ara-aras/esp32-mini-drone/PPT/Drone_Workshop_v2.pptx

M1

M2

M4

M3

IEEE WEEK 2026 · MECH. ENGG.

Introduction
to Drone
Technology

Turn code into motion.
13 Oct · MPH · 9:30–12:30

ESP32 · 500 Hz

AO3400 drivers

6S brushless FPV

ESP32

MPU-6050

Notes: Welcome. Today is about how a drone flies and how we're building one. Our first prototype spun its props and skated across the floor, but it never lifted off. We worked out why, and the second prototype, with a different motor driver, is being built now. We'll start with the physics, then our two prototypes, the firmware, and finally how a full 6S racing drone differs.

## Slide 2

Five stops from physics to flight

02 / ROADMAP

Flight physics

How 4 motors steer
roll, pitch, yaw
and thrust

SLIDES 3–9

01

02

Micro build

Parts, the driver
that failed, and
the MOSFET fix

SLIDES 10–14

500 Hz loop, PID,
motor mixer and
radio links

SLIDES 15–17

03

Firmware

Pro FPV stack

Brushless motors,
DShot and 6S power

SLIDES 18–22

04

Bench rules, flight
modes, PID tuning

SLIDES 23–25

05

Fly safely

Build, Fly & Tune a Drone from Scratch

02 / 26

Notes: Here is the route for today, five stops climbing from theory to flight. First the physics of how four motors steer a quad. Then our micro build on an ESP32, including the driver that failed and the MOSFET fix. Then the firmware: the 500 hertz loop, the PID controller, the motor mixer and the radio links. Then we scale up to a five-inch FPV racer with brushless motors, DShot and 6S power. And finally how to fly safely: bench rules, flight modes and PID tuning.

## Slide 3

How four motors steer a quad

03 / FLIGHT PHYSICS

CW

CCW

CCW

CW

M1 · FL

M2 · FR

M4 · RL

M3 · RR

M1 + M4 (left side)
spin faster

Roll

lean right

M2 + M4 (CCW pair)
spin faster

Yaw

turn right

M3 + M4 (rear pair)
spin faster

Pitch

nose down

All four together;
aim for ≈ 2:1 thrust

Throttle

climb

FRONT ↑

Filled motor = spins faster · Body frame: X forward, Y right, Z down

03 / 26

Notes: A quadcopter steers only by changing how fast each motor spins. Watch the props: M1 front left spins clockwise, M2 front right counter-clockwise, M3 rear right clockwise, M4 rear left counter-clockwise. Neighbours spin opposite ways so their torques cancel and the frame doesn't spin on its own. To roll right, the left pair speeds up. To pitch nose down and fly forward, the rear pair speeds up. To yaw right, the counter-clockwise pair, M2 and M4, speeds up and its reaction torque turns the frame. Throttle is all four together. Hovering needs thrust equal to weight; aim for about 2:1 so there's room left for control. The next slides show roll and pitch in both directions.

## Slide 4

Which prop goes on which motor

03 / FLIGHT PHYSICS

CW

CCW

CCW

CW

M1 · FL

M2 · FR

M4 · RL

M3 · RR

CW prop

on M1 (front left) + M3 (rear right)

CCW prop

on M2 (front right) + M4 (rear left)

blade moves

blade moves

FRONT ↑

air down

air down

Cross-section of one blade · dot = leading edge

The raised, thicker edge of each blade leads, so it bites into the air in the direction the motor turns.

Check: spin each prop by hand the way its motor turns. You should feel air pushed down. A prop on the wrong motor pushes air up, and the drone flips over on take-off.

Props come in matched pairs. Check the arrow or letter on the pack, not just the shape.

04 / 26

Notes: Before anything flies, the props have to match the motors. Clockwise motors, M1 front left and M3 rear right, take clockwise props. Counter-clockwise motors, M2 and M4, take counter-clockwise props. You can tell them apart by the blade: the raised, thicker edge goes first in the direction of rotation, like a wing leading into the air. Props come in matched pairs, so check the arrow or letter printed on them too. Quick test: spin each prop by hand the way its motor turns and feel for air going down. Put one on backwards and that corner pushes air up, and the drone flips the moment it tries to take off.

## Slide 5

03 / FLIGHT PHYSICS

Roll: one side speeds up

CW

CCW

CCW

CW

M1 · FL

M2 · FR

M4 · RL

M3 · RR

FRONT ↑

Roll right

M1 + M4 spin faster

The left side lifts, so the drone leans right and slides that way.

Front view, seen from behind

Filled motor = spins faster · Body frame: X forward, Y right, Z down

05 / 26

Notes: Roll right. M1 and M4, the two motors on the left, spin faster. The left side lifts, the drone leans right, and part of its thrust now pushes it sideways, so it slides right.

## Slide 6

03 / FLIGHT PHYSICS

Roll: one side speeds up

CW

CCW

CCW

CW

M1 · FL

M2 · FR

M4 · RL

M3 · RR

FRONT ↑

Roll left

M2 + M3 spin faster

The right side lifts, so the drone leans left and slides that way.

Front view, seen from behind

Filled motor = spins faster · Body frame: X forward, Y right, Z down

06 / 26

Notes: Now the opposite. M2 and M3 on the right side speed up, the right side lifts, and the drone leans and slides left.

## Slide 7

Pitch: front or back speeds up

03 / FLIGHT PHYSICS

CW

CCW

CCW

CW

M1 · FL

M2 · FR

M4 · RL

M3 · RR

FRONT ↑

Pitch forward

M3 + M4 spin faster

The tail lifts, the nose dips, and the drone moves forward.

Side view, nose on the right

Filled motor = spins faster · Body frame: X forward, Y right, Z down

07 / 26

Notes: Pitch forward. The rear pair, M3 and M4, speeds up. The tail rises, the nose dips, and the tilted thrust pulls the drone forward.

## Slide 8

Pitch: front or back speeds up

03 / FLIGHT PHYSICS

CW

CCW

CCW

CW

M1 · FL

M2 · FR

M4 · RL

M3 · RR

FRONT ↑

Pitch back

M1 + M2 spin faster

The nose lifts and the drone moves backward.

Side view, nose on the right

Filled motor = spins faster · Body frame: X forward, Y right, Z down

08 / 26

Notes: Pitch back is the mirror image. The front pair, M1 and M2, speeds up, the nose comes up, and the drone moves backward.

## Slide 9

04 / TWO MACHINES

Our two drones

Prototype 1

DRV8833

ESP32, customised ESP-Drone FW

8520 coreless brushed

2 × DRV8833 H-bridge boards

ESP-NOW remote + phone app

Skated, never lifted off

Built and tested

motor driver

BRAIN

MOTORS

DRIVER

RADIO

RESULT

ESP32, customised ESP-Drone FW

8520 coreless brushed

4 × AO3400 MOSFETs

ESP-NOW remote + phone app

Not built yet

Prototype 2

AO3400

Being built

motor driver

BRAIN

MOTORS

DRIVER

RADIO

STATUS

Build, Fly & Tune a Drone from Scratch

09 / 26

Notes: These are our two drones. Both use an ESP32, an MPU-6050, four 8520 coreless motors and a single LiPo cell, and both run firmware we customised from Espressif's official ESP-Drone firmware. The only difference is the motor driver. Prototype 1 used two DRV8833 H-bridge boards. It spun its props but never lifted off. Prototype 2 replaces them with four AO3400 MOSFETs, one per motor, and we're still building it.

## Slide 10

What is on our 50-gram quad

05 / MICRO BUILD

ESP32 DevKit V1

Dual-core 240 MHz; one core
runs the 500 Hz flight loop

MPU-6050 IMU

3-axis gyro + accelerometer,
I²C at 400 kHz, at the CG

8520 coreless motor × 4

8.5 × 20 mm, about 5 g each,
turning 55 mm props

ESP32

1S LiPo power

3.7 V cell, TP4056 USB charger,
5 V boost keeps the ESP32 stable,
voltage read on GPIO 34
(100k / 100k divider)

AO3400 driver × 4

One low-side MOSFET per motor,
16 kHz PWM from the ESP32

Dashed teal outline = battery under the frame · Orange squares = MOSFET drivers

10 / 26

Notes: Here's what goes on the quad. The ESP32 DevKit is the brain: dual core at 240 MHz, and one core runs the 500 Hz flight loop. The MPU-6050 gives us a three-axis gyro and accelerometer over I2C at 400 kHz, and it sits at the centre of gravity so rotation doesn't show up as false acceleration. The 8520 coreless motors are 8.5 by 20 mm, about 5 g each, on 55 mm props. In prototype 2 each motor gets its own AO3400 MOSFET, switched at 16 kHz. Power is one LiPo cell with a TP4056 USB charger, a 5 V boost so the ESP32 doesn't brown out, and a 100k/100k divider so we can read the battery voltage on GPIO 34.

## Slide 11

< 2.7 V

reached the motors (measured)

from a battery rated 3.7 V

props spinning, no lift

06 / THE ROADBLOCK

Prototype 1 never
left the floor

ESP32, MPU-6050, four 8520 motors,
a 1S LiPo, and two DRV8833
H-bridge boards driving the motors.

At full throttle the props spun,
but the quad only skated across
the floor. It never lifted off.

Phase 2 · Micro build

11 / 26

Notes: Prototype 1 had the same ESP32, IMU, motors and battery, with two DRV8833 H-bridge boards driving the motors. At full throttle the props spun, but the quad only skated across the floor. It never lifted off. At the motor terminals we read under 2.7 V from a 3.7 V battery, so about a volt was going missing somewhere.

## Slide 12

Where the missing volt went

07 / DIAGNOSIS

3.7 V nominal

1S LiPo

3.7 V

I ≈ 3.5 A

DRV8833

≈ 360 mΩ

< 2.7 V

8520 motor

M

In the chip:

3.5 A × 0.36 Ω ≈ 1.3 V

never reaches the motor

Driver limit

1.5 A RMS, 2 A peak
per channel (datasheet)

Motor demand

8520s pull 3.5–4.2 A
at full throttle

Not enough lift

Less voltage at the motor,
so the props can't lift it

Lesson: H-bridge ICs suit 0.5–0.8 A toy-car motors. Coreless drone motors need a bigger switch.

DRV8833 figures: TI datasheet (typical RDS(on) high + low side). Motor current: typical 8520 stall figure.

12 / 26

Notes: Follow the current. Inside each DRV8833 channel it passes through a high-side and a low-side transistor, about 360 milliohms in total according to TI's datasheet. At full throttle an 8520 motor wants 3.5 to 4 A. Ohm's law: 3.5 A times 0.36 ohm is about 1.3 V dropped inside the chip, so it never reaches the motor. The chip is also rated for only 1.5 A RMS per channel. With less voltage the motors can't spin fast enough to lift the quad. H-bridge chips like this are made for toy-car motors that run in both directions at under an amp. A drone motor turns one way and needs a lot more current.

## Slide 13

One MOSFET per motor

08 / THE FIX

VBAT 3.7 V

SS24

8520

PWM

AO3400

10 kΩ

GND

3

1

2

M

ESP32 GPIO

Current path: battery → motor → switch → ground

M1 GPIO32 · M2 GPIO25 · M3 GPIO33 · M4 GPIO26

16 kHz, 12-bit PWM from the ESP32 LEDC timers

Low-side switch, ×4. Pins from Drone/src/config.h

13 / 26

AO3400 N-channel MOSFET

Logic-level: a 3.3 V gate turns it fully
on. Tens of mΩ, 5.7 A continuous.

1

Battery +
3.7 V

M

8520 motor

3

AO3400
switch

1

GND

SS24 diode across the motor: catches the spike when the switch opens

PWM: on/off 16,000 times a second. More on-time = faster motor.

10 kΩ gate pull-down

Holds the gate low while the ESP32 boots,
so motors cannot twitch at power-up.

2

2

10 kΩ gate to GND keeps the switch off while the ESP32 boots

ESP32 GPIO

SS24 Schottky diode (40 V, 2 A)

Gives the motor current a path when the
switch opens, so there is no voltage spike.

3

Notes: Prototype 2 swaps the H-bridge for one N-channel MOSFET per motor. Read the diagram left to right: current leaves the battery, goes through the motor, then through the MOSFET, and into ground. The MOSFET is just a switch. The ESP32 turns it on and off 16,000 times a second, and the share of time it's on sets the motor speed. Three parts make it work. The AO3400 is logic-level, so the ESP32's 3.3 V turns it fully on, with tens of milliohms of resistance and a 5.7 A rating. A 10 k resistor from gate to ground keeps it off while the ESP32 boots, so the motors can't twitch at power-up. And the SS24 diode across the motor gives the motor's current somewhere to go when the switch opens, so there's no voltage spike. Motors 1 to 4 use GPIO 32, 25, 33 and 26.

## Slide 14

09 / BEFORE VS AFTER

Same motors, new driver

1.5 A RMS · 2 A peak

< 2.7 V (measured)

Built and tested

Skated on the floor

≈ 360 mΩ

DRV8833 H-bridge

✕ FAILED

Tens of mΩ (≈ 10× less)

5.7 A continuous

≈ 3.5 V (calculated)

Not built yet

Should lift off

AO3400 MOSFET

PLANNED

RESISTANCE

CURRENT

AT MOTOR

STATUS

RESULT

Same motors, same battery, same code. Only the driver changes.

First test once it's built: measure the voltage at the motor terminals.

Build, Fly & Tune a Drone from Scratch

14 / 26

Notes: Here's what should change. The DRV8833 path is about 360 milliohms; the MOSFET is tens of milliohms, roughly ten times less. The DRV8833 is rated 1.5 A RMS; the AO3400 handles 5.7 A continuous. At 3.5 A through about 50 milliohms we'd lose around 0.2 V, so we expect roughly 3.5 V at the motor. That's a calculation, not a measurement, because prototype 2 isn't built yet. Same motors, same battery, same code: only the driver changes. Once it's built, the first thing we'll do is put a multimeter on the motor terminals.

## Slide 15

Two cores, one 500 Hz flight loop

10 / FIRMWARE

CORE 0 · WI-FI + ESP-NOW STACK

Radio receives stick packets from the remote or the phone app

Read IMU

Fuse

PID

Mix

PWM out

gyro + accel, I²C

attitude estimate

angle → rate loop

Quad-X mixer

4 motors, 16 kHz

CORE 1 · FLIGHT TASK · 500 Hz

setpoints

Commands

Telemetry

Battery + LED

Motor watchdog

serial + web page

+ blackbox log

voltage, status

task silent 50 ms → cut

CORE 1 · loop() · LOW PRIORITY

Rule: only the flight task touches I²C and the motors; the rest uses locked shared data.

Arduino framework on FreeRTOS · no external libraries

15 / 26

Notes: Now the firmware. The ESP32 has two cores. Core zero runs the Wi-Fi and ESP-NOW radio stack, which receives stick packets and turns them into setpoints. Core one runs our flight task every two milliseconds, five hundred times a second, at high priority: read the IMU, fuse the readings into an attitude estimate, run the PID controller, mix the corrections into four motor outputs, and write the PWM. Also on core one, at low priority, the normal Arduino loop handles serial and web commands, telemetry and the blackbox log, battery and LED, and a watchdog that cuts the motors if the flight task goes silent for fifty milliseconds. The rule that keeps this safe is that only the flight task ever touches I2C and the motors; everything else talks to it through small locked shared buffers.

## Slide 16

Inside every 2 ms tick

11 / CONTROL LOOP

≤ 30°

≤ 200°/s

r, p, y

Pilot stick

Angle loop

Rate loop

Mixer

Motors

±500 units

P × 4

PID vs gyro

Quad-X

M1–M4

gyro rate

angle estimate

IMU + complementary filter

Complementary filter, α = 0.995

angle = 0.995 × (angle + gyro × dt)
+ 0.005 × accel_angle

Gyro is smooth but drifts. Accel knows “down” but
is noisy. Accel is ignored outside 0.8–1.2 g.

Quad-X mixer (mixer.cpp)

m1 = t + r + p − y // FL CW
m2 = t − r + p + y // FR CCW
m3 = t − r − p − y // RR CW
m4 = t + r − p + y // RL CCW

D acts on measurement · I frozen below 15 % throttle

t = throttle, r/p/y = roll/pitch/yaw corrections · values from Drone/src/config.h

16 / 26

Notes: Inside each two millisecond tick, the controller is a cascade of two loops. The pilot's stick becomes a target angle, at most thirty degrees. The outer angle loop compares that with the estimated angle and multiplies the error by four to get a target rotation rate, capped at two hundred degrees per second. The inner rate loop is a full PID that compares the target rate with what the gyro measures. The mixer then turns roll, pitch and yaw corrections into four motor commands. The angle estimate comes from a complementary filter: we trust the gyro 99.5 percent because it is smooth, and the accelerometer half a percent because it knows which way is down but is noisy. If the accelerometer reads far from one g, during a hard manoeuvre, we ignore it. Two more details: the D term acts on the measurement so a stick jump does not kick the motors, and the I term is frozen below fifteen percent throttle so it does not wind up on the ground.

## Slide 17

Three ways to talk to the drone

12 / RADIO LINKS

ESP-Drone phone app

UDP to 192.168.43.42 : 2390
Zero throttle, then raise to arm

Web dashboard

Live telemetry, PID tuning,
bench tests while disarmed

Handheld remote

ESP-NOW on Wi-Fi channel 1
Peer-to-peer, no router
13-byte packet (below)

Wi-Fi AP

192.168.43.42

magic

seq

throttle

roll

pitch

yaw

flags

ESP-NOW packet · 13 bytes, packed

throttle 0 – 1000
sticks −500 … +500
flags bit 0 = arm switch

Failsafe: no packet for 500 ms while armed → motors disarm.

Packet struct is duplicated in Drone/src/radio.h and Transmitter/Transmitter.ino

17 / 26

Notes: There are three ways to talk to this drone. A handheld remote, another ESP32, sends ESP-NOW packets on Wi-Fi channel one, peer to peer, no router needed. Each packet is thirteen bytes: a magic number, a sequence counter, throttle from zero to a thousand, and roll, pitch and yaw from minus five hundred to plus five hundred, plus a flags byte where bit zero is the arm switch. Second, the drone runs its own Wi-Fi access point at 192.168.43.42, so the ESP-Drone phone app can fly it over UDP port 2390. To arm from the app you bring throttle to zero after connecting and then raise it. Third, a web dashboard shows live telemetry, lets you tune PID gains, and runs bench tests while disarmed. Whatever the link, if no packet arrives for 500 milliseconds while armed, the drone disarms itself.

## Slide 18

PHASE 04 OF 05

04

Scaling up: the
5-inch FPV racer

Same physics. Everything else gets
bigger, faster and digital.

Brushless motors replace brushed

An ESC with digital DShot replaces the MOSFET

6S LiPo: 22.2 V instead of 3.7 V

18 / 26

Notes: That is our micro quad. Now let us scale up to a five-inch FPV racer. The physics does not change at all. What changes is everything around it: brushless motors instead of brushed ones, an electronic speed controller speaking a digital protocol instead of a simple MOSFET, and a six-cell battery at 22.2 volts instead of a single 3.7 volt cell.

## Slide 19

Inside a 5-inch racer, layer by layer

14 / FPV STACK

Flight controller

4-in-1 ESC

Carbon frame + motors

6S LiPo

Receiver

exploded view · not to scale

22.2 V nominal, ~1300 mAh, 120 C

2.4 GHz, up to 1000 packets/s (short range)

STM32 F7/H7, Betaflight, ICM-42688 gyro

45–60 A per motor, DShot600 + RPM telemetry

5-inch carbon, 2207 motors at 1750–1960 KV

6S LiPo battery

ExpressLRS receiver

Flight controller

4-in-1 ESC

Frame + motors

Typical build · Betaflight runs an 8 kHz gyro + PID loop on F7/H7

19 / 26

Notes: Here is a racer taken apart, layer by layer. On top, a 6S LiPo, typically around 1300 milliamp hours with a high C rating. Below it the ExpressLRS receiver on 2.4 gigahertz, which can send up to a thousand packets a second at short range, trading rate for range. Then the flight controller, an STM32 F7 or H7 running Betaflight with a low-noise gyro such as the ICM-42688, running its gyro and PID loop at eight kilohertz, sixteen times faster than ours. Under that, a four-in-one ESC rated 45 to 60 amps per motor, speaking DShot600. At the bottom, a five-inch carbon frame with 2207 motors, usually 1750 to 1960 KV on six cells.

## Slide 20

Brushed vs brushless, and what KV means

15 / MOTORS

Brushed · our 8520

- Brushes rub a commutator, so they wear out

- Plain DC: our MOSFET switches it on and off

- Cheap; fine for quads under about 60 g

Reading the name “2207”

stator, side view · wider = torque, taller = top-end RPM

22 mm stator diameter

07 mm

Brushless · 2207 racer motor

- No brushes: the ESC switches 3 phases

- 12 coils, 14 magnets (12N14P)

- Bearings are the only part that wears

KV = RPM per volt, with no load

1960 KV × 22.2 V (6S)

≈ 43,500 RPM

Under load it spins slower. 6S builds use
lower KV (1750–1960), 4S builds higher (2400+).

Build, Fly & Tune a Drone from Scratch

20 / 26

Notes: Our brushed motors have carbon brushes that rub on a commutator, so they wear out, but they are cheap and need only simple on-off PWM, which is perfect under sixty grams. Brushless motors have no brushes; the ESC switches three phases electronically, a typical racer motor has twelve coils and fourteen magnets, and only the bearings wear. The name 2207 is just the stator size: 22 millimetres in diameter, 7 millimetres tall. Wider gives more torque, taller gives more top-end speed. KV means RPM per volt with no load, so a 1960 KV motor on a 22.2 volt pack spins at about 43,500 RPM unloaded, and slower under the load of a propeller. That is why six-cell builds use lower KV and four-cell builds use higher KV.

## Slide 21

DShot: throttle sent as a number

16 / ESC PROTOCOL

Old way · PWM / OneShot

throttle = how long the pulse stays high;
drifts, needs calibration

low

high

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
throttle · 11 bits · e.g. 1046

T

CRC · 4 bits

48–2047 = throttle · 1–47 = commands · T = telemetry request

DShot600 · one 16-bit frame

26.7 µs

per frame: 16 bits at 600 kbit/s

The ESC replies with motor RPM on the same wire.
Betaflight uses it to notch out motor noise.

Bidirectional DShot

Active braking (“damped light”)

The ESC brakes the prop when throttle drops,
so the quad reacts and settles faster.

Example frame: throttle 1046, telemetry 0, CRC = (v ⊕ v≫4 ⊕ v≫8) & 0xF

21 / 26

Notes: Older ESC protocols encoded throttle as the width of a pulse, between one and two milliseconds. That analog timing drifts and needs calibration. DShot sends throttle as a number. Each frame is sixteen bits: eleven bits of throttle, where 48 to 2047 is throttle and 1 to 47 are special commands, one bit to request telemetry, and a four-bit checksum, so corrupted frames are thrown away. At 600 kilobits per second a frame takes just under 27 microseconds. Two extras matter for flying. Bidirectional DShot lets the ESC send motor RPM back on the same wire, and Betaflight uses that to place notch filters exactly on the motor noise. Active braking lets the ESC slow the prop down instead of letting it coast, so the quad responds and settles faster.

## Slide 22

Why racers moved from 4S to 6S

17 / POWER

4S · 14.8 V NOMINAL

68 A

needed for a 1000 W punch-out

6S · 22.2 V NOMINAL

45 A

for the same 1000 W: less heat, less sag

I = P ÷ V. Heat in wires and cells grows with I²R, so a third less current matters a lot.

How much can a pack give?

max current = capacity × C

1.3 Ah × 120 C = 156 A

Pull more and the cells puff up and age fast.

Protect the electronics

- Low-ESR cap on the ESC pads, e.g. 1000 µF, rated 35 V+ (50 V gives margin on 6S)

- A TVS diode clamps voltage spikes from active braking

Full charge: 4.2 V per cell (6S = 25.2 V) · storage ≈ 3.8 V per cell

22 / 26

Notes: Why did racers move from four cells to six? Power is voltage times current. For the same thousand-watt punch, a 4S pack at 14.8 volts must deliver about 68 amps, while a 6S pack at 22.2 volts needs only about 45. Heat in the wires and in the cells grows with current squared times resistance, so a third less current means far less heat and far less voltage sag. To know what a pack can deliver, multiply capacity by C rating: a 1.3 amp-hour pack rated 120 C gives 156 amps continuous. Pull more and the cells puff up and age quickly. And protect your electronics: a low-ESR capacitor across the ESC pads, for example a thousand microfarads rated 35 volts or more, with 50 volts giving extra margin on 6S, and optionally a TVS diode to clamp the spikes that active braking pushes back into the battery line.

## Slide 23

Four rules before every power-up

18 / BENCH SAFETY

1 · Props off on the bench

Never power motors with props fitted.
A surprise spin-up cuts in milliseconds.

2 · Smoke stopper on first power-up

A resettable fuse in the battery lead
trips before a short can burn the board.

3 · Check for shorts first

Multimeter across VBAT and GND before
the battery goes in: no near-zero reading.

4 · Test the failsafe

While disarmed, switch the radio off.
The drone must stay disarmed.

Our firmware enforces it too

Motor tests stay locked until you type
props off (unlock lasts 5 minutes)

Motor tests and setting changes
run only while disarmed

No radio packet for 500 ms while armed
→ the drone disarms itself

Never weaken these without a reason.

Flight task silent for 50 ms
→ loop() cuts the motors

Treat every quad on the bench as armed.

23 / 26

Notes: Before anything flies, four rules. First, props off on the bench, always; a motor that spins up unexpectedly can cut you in milliseconds. Second, use a smoke stopper, a resettable fuse in the battery lead, the first time you power a new build, so a short trips the fuse instead of burning the board. Third, check for shorts with a multimeter across battery positive and ground before plugging in; you should never see a near-zero reading. Fourth, test the failsafe: with the drone disarmed, switch the radio off and confirm the drone stays disarmed. Our own firmware enforces the same ideas. Motor tests are locked until you type props off, which unlocks them for five minutes. Tests and settings changes only run while disarmed. No radio packet for 500 milliseconds while armed disarms the drone, and if the flight task stops for 50 milliseconds, the main loop cuts the motors.

## Slide 24

Angle mode vs Acro mode

19 / FLIGHT MODES

Angle · self-levelling

- Stick sets the tilt angle (ours: max 30°)

- Let go and it levels itself

- Uses gyro + accelerometer

START HERE

30°

Learn in Angle, then practise Acro in a simulator before real flips.

Our ESP32 firmware flies in Angle mode (MAX_ANGLE_DEG = 30)

24 / 26

Acro · rate mode

- Stick sets how fast it rotates

- Let go: it holds its attitude, even inverted

- Gyro only; accelerometer ignored

FLIPS + RACING

e.g. 670°/s at full stick

Notes: There are two main ways a flight controller reads your sticks. In Angle mode the stick sets a tilt angle, at most thirty degrees in our firmware, and when you let go the drone levels itself using the gyro and the accelerometer. That's the mode our ESP32 firmware uses, and it's where every beginner should start. In Acro, or rate mode, the stick sets how fast the drone rotates, for example 670 degrees per second at full stick, and when you let go it holds whatever attitude it's in, even upside down. It uses only the gyro, and it's what makes flips and racing possible. Learn in Angle, then practise Acro in a simulator before trying real flips.

## Slide 25

What each PID gain does

20 / PID TUNING

Response to a sudden stick move

too much P

tuned

too little P

illustrative

target

time →

Stiffness · reacts to the error now

Too high: fast ringing, buzzing motors
Too low: sloppy, drifts off the line

P

Memory · fixes error that lingers

Too high: slow wobble after a move
Too low: will not hold its angle in wind

I

Damping · brakes the motion

Too high: amplifies noise, hot motors
Too low: overshoot, prop-wash shake

D

1 · P up until it rings, then −15 %

2 · D up until overshoot stops

3 · I up until it holds angle

Start with I and D at zero. Check motor temperature after every D change. Our gains tune live from the web page.

25 / 26

Notes: Finally, tuning. The graph is illustrative: it shows how the drone responds to a sudden stick movement. P is stiffness; it reacts to the error right now. Too much P and the drone overshoots and rings, with buzzing motors. Too little and it feels sloppy and drifts off line. I is memory; it fixes errors that linger, like wind or an off-centre battery. Too much gives a slow wobble after a move; too little and it will not hold its angle. D is damping; it brakes the motion before it overshoots. Too much amplifies sensor noise and makes motors hot; too little gives overshoot and prop-wash shaking. The method: start with I and D at zero, raise P until it rings and back off about fifteen percent, raise D until the overshoot stops while checking motor temperature, then raise I until it holds its angle. On our drone you can do all of this live from the web page.

## Slide 26

Measure first,
then design.

21 / WRAP-UP

✓ Explain how four motors steer a quad

✓ Choose a motor driver from its datasheet

✓ Read a 500 Hz loop: IMU → PID → mixer

✓ Spec a 6S racer and tune PID safely

YOU CAN NOW

Fly home by itself if the link drops

HD digital video

Low-latency HD goggles instead of analog

Optical flow + barometer

Hands-free hover, even indoors

NEXT UPGRADES

GPS rescue

ATTENDEES ONLY

Firmware, slides + speaker notes

github.com/ara-aras/esp32-mini-drone

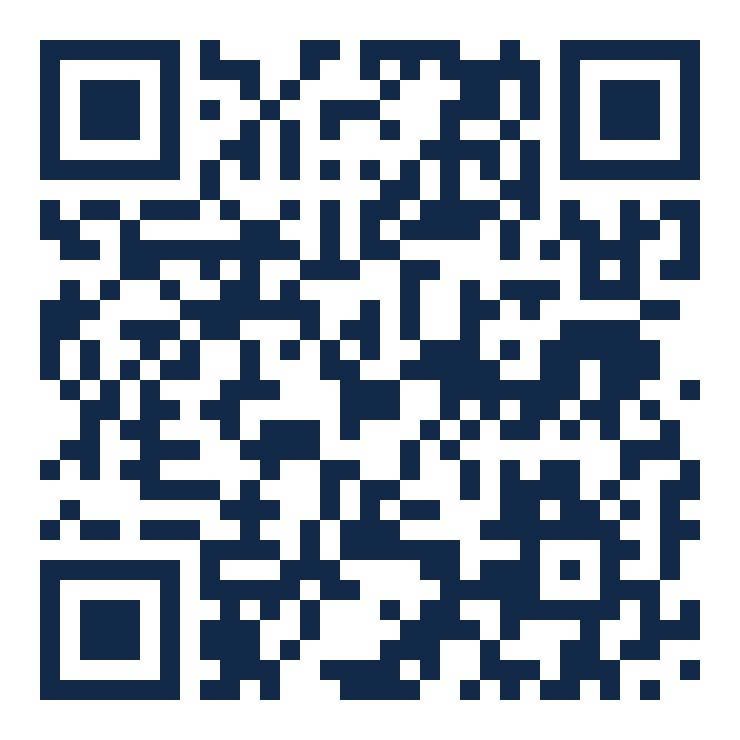
[picture p1: figure]
QR code: github.com/ara-aras/esp32-mini-drone

Questions? Then go build one.

26 / 26

Notes: If you remember one thing from today, let it be this: measure first, then design. Prototype 1 didn't fly, and measuring the voltage at the motors is what showed us why. You can now explain how four motors steer a quad, choose a motor driver from its datasheet, read a 500 hertz control loop from IMU to PID to mixer, and spec a 6S racer and tune it safely. Good next upgrades are GPS rescue, so the drone flies home if the link drops, HD digital video, and optical flow with a barometer for hands-free hovering indoors. Questions? Then go build one. One last thing: the QR code is the repo with the firmware, these slides and my speaker notes. It is only for the people in this room; I am not posting the link anywhere else, so anyone who skipped has to ask one of you.
