ara-aras/esp32-mini-drone/(commit log)

2026-10-13 ESP32 mini drone: firmware, transmitter, tests and workshop slides
    Custom Arduino flight controller for a 1S ESP32 quadcopter, an ESP-NOW
    transmitter sketch, host unit tests and the IEEE workshop deck.
    The Wi-Fi AP password now comes from an untracked src/secrets.h.
2026-10-13 Workshop deck: roll/pitch morph slides, two-prototype story, simpler MOSFET diagram
2026-10-13 Workshop deck: add prop placement slide (CW/CCW props, leading edge)
